raniahaas/DoubleOrNothing/3D models/MS561101BA03-50--3DModel-STEP-56544.STEP

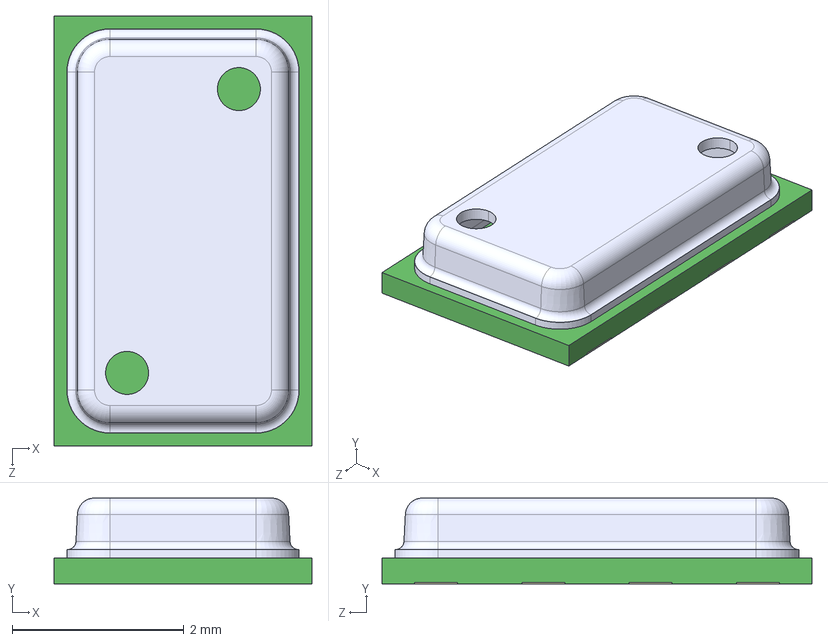
[picture p1: CAD file, 2026-05-17]
3D models/MS561101BA03-50--3DModel-STEP-56544.STEP
3.00 x 1.00 x 5.00 mm
