raniahaas/DoubleOrNothing/(list of files, cad)

Other CAD files:
3D models/Final Custom Avionics PCB/NX Model/C_0603_1608Metric.prt
3D models/Final Custom Avionics PCB/NX Model/Custom Avionics PCB Final - Spring 2026 (Assembly).prt
3D models/Final Custom Avionics PCB/NX Model/JST_PH_B2B-PH-K_1x02_P2.00mm_Vertical.prt
3D models/Final Custom Avionics PCB/NX Model/LGA-14_3x2.5mm_P0.5mm_LayoutBorder3x4y.prt
3D models/Final Custom Avionics PCB/NX Model/LGA-8_3x5mm_P1.25mm.prt
3D models/Final Custom Avionics PCB/NX Model/R_0402_1005Metric.prt
3D models/Final Custom Avionics PCB/NX Model/TSOT-23.prt
3D models/Final Custom Avionics PCB/NX Model/TerminalBlock_Phoenix_MPT-0,5-2-2.54_1x02_P2.54mm_Horizontal.prt
3D models/Final Custom Avionics PCB/NX Model/TerminalBlock_Phoenix_MPT-0,5-4-2.54_1x04_P2.54mm_Horizontal.prt
3D models/Final Custom Avionics PCB/NX Model/Untitled_PCB.prt
3D models/Final Custom Avionics PCB/NX Model/Untitled_copper.prt
3D models/Final Custom Avionics PCB/NX Model/Untitled_pad.prt
3D models/Final Custom Avionics PCB/NX Model/Untitled_silkscreen.prt
3D models/Final Custom Avionics PCB/NX Model/Untitled_silkscreen131156.prt
3D models/Final Custom Avionics PCB/NX Model/Untitled_via.prt
