raniahaas/DoubleOrNothing/Untitled.kicad_sch

## KiCad design Untitled.kicad_sch (2026-05-17)

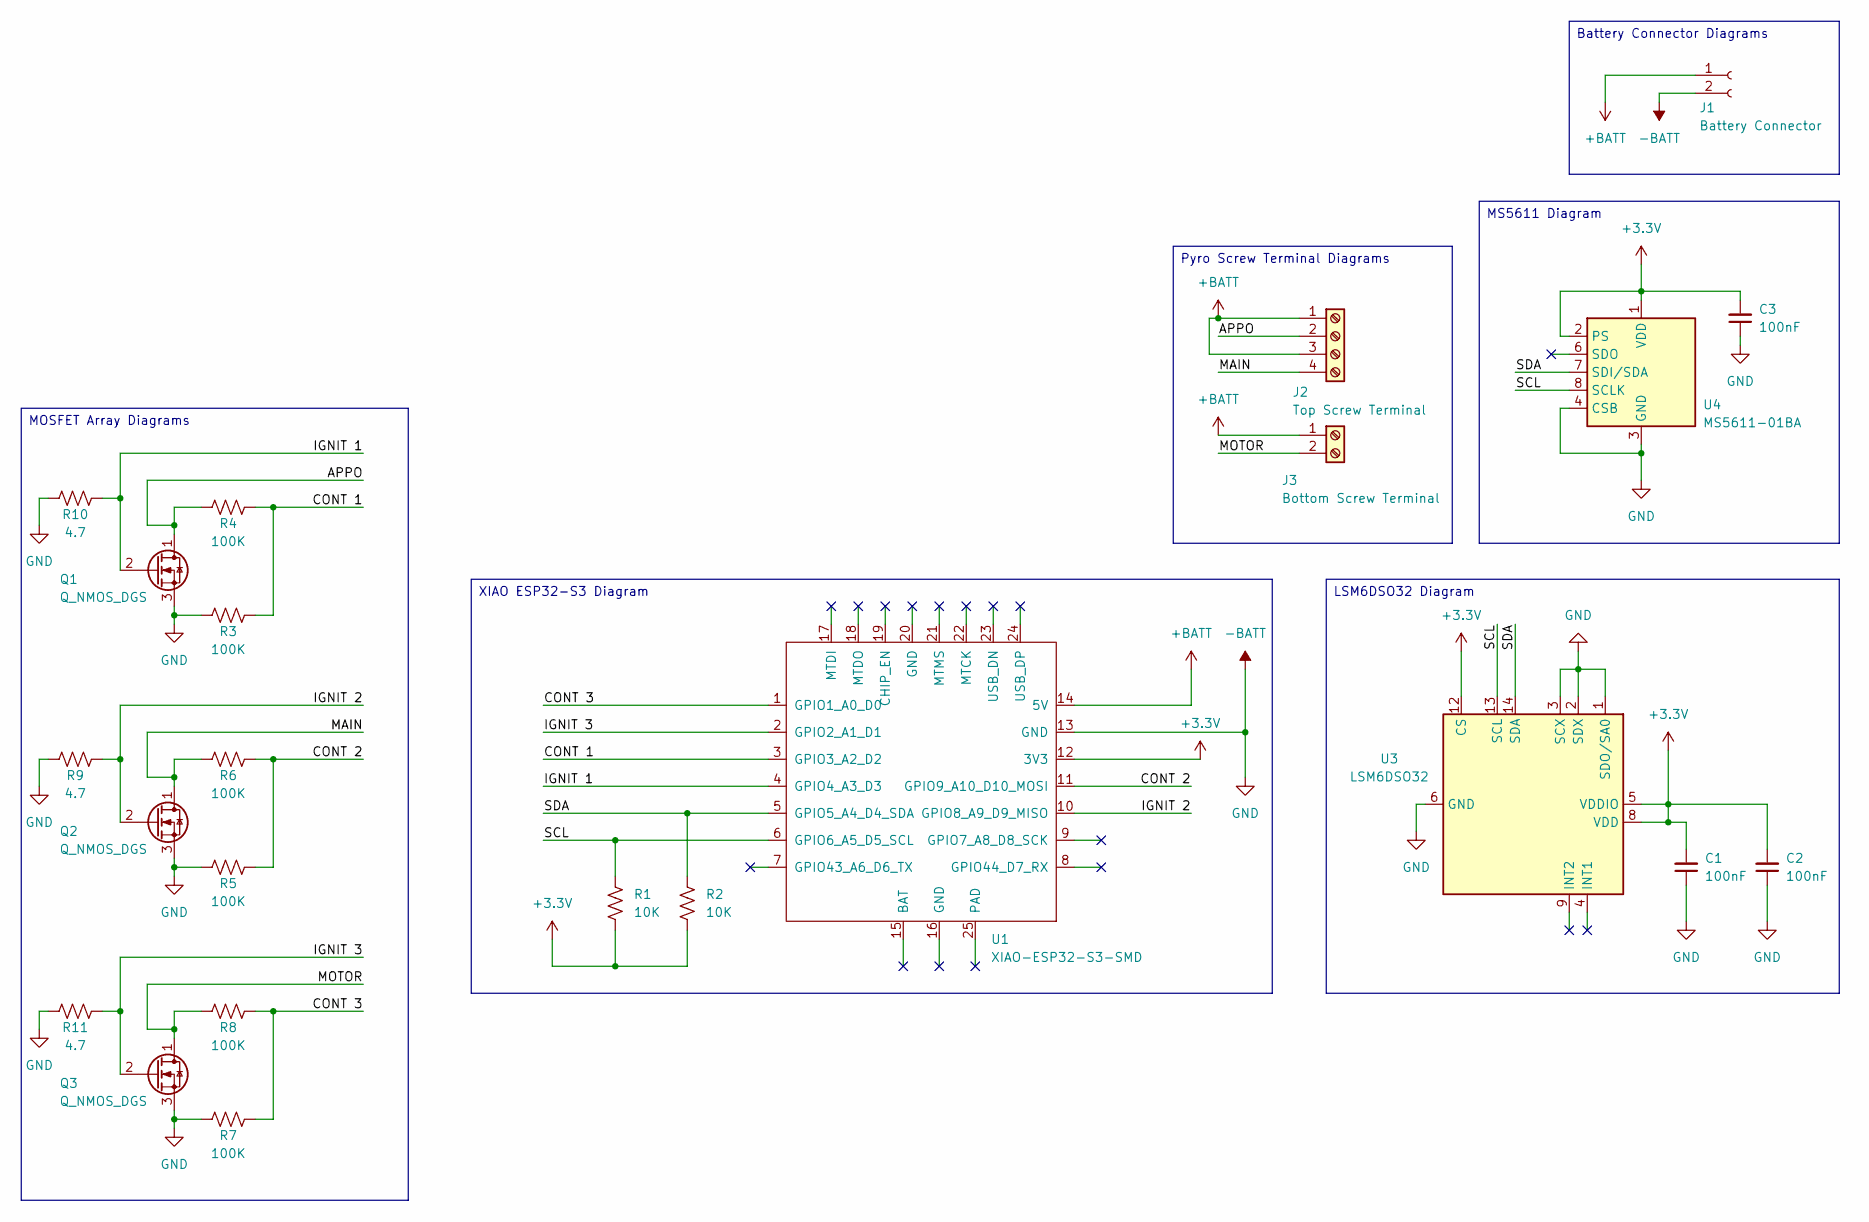
[picture p2: schematic Untitled.kicad_sch]

Parts:
C1, C2, C3: 100nF; C_0603_1608Metric
J1: Battery Connector; JST_PH_B2B-PH-K_1x02_P2.00mm_Vertical
J2: Top Screw Terminal; TerminalBlock_Phoenix_MPT-0,5-4-2.54_1x04_P2.54mm_Horizontal
J3: Bottom Screw Terminal; TerminalBlock_Phoenix_MPT-0,5-2-2.54_1x02_P2.54mm_Horizontal
Q1, Q2, Q3: Q_NMOS_DGS; TSOT-23
R1, R2: 10K; R_0402_1005Metric
R3, R4, R5, R6, R7, R8: 100K; R_0402_1005Metric
R9, R10, R11: 4.7; R_0402_1005Metric
U1: XIAO-ESP32-S3-SMD; XIAO-ESP32S3-DIP
U3: LSM6DSO32; LGA-14_3x2.5mm_P0.5mm_LayoutBorder3x4y
U4: MS5611-01BA; LGA-8_3x5mm_P1.25mm

Connections:
+3.3V: C1.2, C2.2, C3.2, R1.2, R2.2, U1.12 (3V3), U3.5 (VDDIO), U3.8 (VDD), U3.12 (CS), U4.1 (VDD), U4.2 (PS)
+BATT: J1.1, J2.1, J2.3, J3.1, U1.14 (5V)
-BATT: C1.1, C2.1, C3.1, J1.2, Q1.3 (S), Q2.3 (S), Q3.3 (S), R3.2, R5.2, R7.2, R9.2, R10.2, R11.2, U1.13 (GND), U3.1 (SDO/SA0), U3.2 (SDX), U3.3 (SCX), U3.6 (GND), U3.7 (GND), U4.3 (GND), U4.4 (CSB), U4.5 (CSB)
APPO: J2.2, Q1.1 (D), R4.2
CONT 1: R3.1, R4.1, U1.3 (GPIO3_A2_D2)
CONT 2: R5.1, R6.1, U1.11 (GPIO9_A10_D10_MOSI)
CONT 3: R7.1, R8.1, U1.1 (GPIO1_A0_D0)
IGNIT 1: Q1.2 (G), R10.1, U1.4 (GPIO4_A3_D3)
IGNIT 2: Q2.2 (G), R9.1, U1.10 (GPIO8_A9_D9_MISO)
IGNIT 3: Q3.2 (G), R11.1, U1.2 (GPIO2_A1_D1)
MAIN: J2.4, Q2.1 (D), R6.2
MOTOR: J3.2, Q3.1 (D), R8.2
SCL: R1.1, U1.6 (GPIO6_A5_D5_SCL), U3.13 (SCL), U4.8 (SCLK)
SDA: R2.1, U1.5 (GPIO5_A4_D4_SDA), U3.14 (SDA), U4.7 (SDI/SDA)

Notes on the sheet:
XIAO ESP32-S3 Diagram
LSM6DSO32 Diagram
MS5611 Diagram
Battery Connector Diagrams
MOSFET Array Diagrams
Pyro Screw Terminal Diagrams
