raniahaas/DoubleOrNothing/(commit log)

2026-03-16 POST-ORDER - Schematic Check
    Changed tiny formatting setup on schematic when viewing the BOM, may not even be changed at all.
2026-03-16 PCB MOSFET Testing
    Un-commented function calls for continuity testing, commented out function calls for sensors due to current board not having sensors. Added a third mode to the continuity test function and improved code to allow to allow continuity testing without serial monitor active (for blink testing modes). Added more comments to both main and test functions file.
2026-03-16 Grammar Fix
    Fixed spelling in warning comments for ignition testing modes.
    [test_functions.cpp]
2026-03-17 Quick Barometer Testing for PCB
    Re-added functionality for standalone barometer initialization and reading to main code for function testing I2C interface on PCB w/ MS5611 breakout board. Created barometer_test function to test barometer without trying to call IMU (if you use other test function it crashes the board because the IMU doesn't exist).
    [main.cpp, test_functions.cpp, test_functions.h]
2026-03-21 New IMU Testing Function
    Added a new function, mosfet_IMU_test that allows for testing the IMU and MOSFETs. Function opens different MOSFETs depending on what direction the board/computer is oriented, the function is intended to be used with LEDs only, NOT PYRO CHARGES.
    Also made some small changes and added documentation to test_functions.cpp
2026-03-22 Added Pyro Serial Remote Function
    Added a function that allows for pyro channels to be activated via a serial monitor interface. Current version of the program only allows for a single port to be activated at one time.
    Documentation on the function is limited for now, it also lacks a full header, these will be added at s different date.
2026-03-23 Tilt Formula
    Added code to determine tilt angle based on roll and pitch.
2026-03-23 Initial apogee detection design
    moved function out into separate file; prints AFTER logging has ended with the data--issue regarding acceleration logging
    [localFunctions.cpp, localFunctions.h, main.cpp]
2026-03-25 edit file names for the correct project
    [localFunctions.cpp, localFunctions.h, main.cpp, test_functions.cpp, test_functions.h]
2026-04-08 Reset main.cpp
    Reset the code in main.cpp to the original code that was being used before the merge request last week.
    [main.cpp]
2026-04-10 update from Loring
    function declartions for accel, yaw, pos, etc
2026-04-10 saves for fixing file upload
    [localFunctions.cpp, localFunctions.h, main.cpp]
2026-05-17 intial readme for design process
    Added project details, goals, and initial designs for the TwoStageAvionicsBay project. Included information on avionics components and PCB design.
2026-05-17 Final Versions for PCB Design
    NX Models and PCB from the finished PCB design
    [C_0603_1608Metric.prt, Custom Avionics PCB Final - Spring 2026 (Assembly).prt, JST_PH_B2B-PH-K_1x02_P2.00mm_Vertical.prt, LGA-14_3x2.5mm_P0.5mm_LayoutBorder3x4y.prt, LGA-8_3x5mm_P1.25mm.prt, MS561101BA03-50--3DModel-STEP-56544.STEP, R_0402_1005Metric.prt, TSOT-23.prt]
